facundo097/IPTC_SAS/SAS_Component_1/Spectrolab_UTJ_0.png

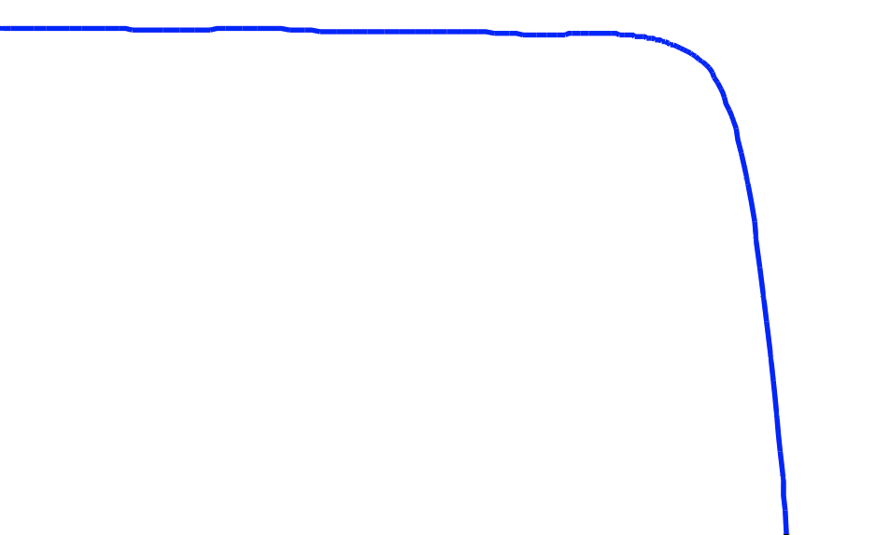
SAS_Component_1/Spectrolab_UTJ_0.png
