facundo097/IPTC_SAS/Chassis/Bill of materials.xlsx

Elemento | Cantidad | Peso Unitario | Peso Total | Precio Unitario | Precio Total
Panel frontal (acrílico de 6mm) | 1 | 0.21569 | 0.21569 | 48.08 | 48.08
Panel trasero (acrílico de 6mm) | 1 | 0.23792 | 0.23792
Panel lateral (acrílico de 6mm) | 2 | 0.32995 | 0.65990
Panel superior (acrílico de 6mm) | 1 | 0.62521 | 0.62521
Panel inferior (acrílico de 6mm) | 1 | 0.63895 | 0.63895
Anillo espaciador (acrílico de 6mm) | 4 | 0.00010 | 0.00042
Malla PVC para filtrado de polvo (https://www.amazon.com/MoKo-400x300mm-Dustproof-Magnetic-Computer/dp/B0BHSS55RM?sp_csd=d2lkZ2V0TmFtZT1zcF9hdGY) | 1 | 0.01300 | 0.01300 | 10.00 | 10.00
Convertidor AC-DC Mean Well IRM-60-24ST (https://www.mouser.co.cr/ProductDetail/MEAN-WELL/IRM-60-24ST?qs=yID0DEbBT%252Bl6uGk%2FETyecw%3D%3D) | 1 | 0.20500 | 0.20500 | 27.00 | 27.00
Conector de alimentación AC IEC320 (https://www.microjpm.com/products/ad53892/) | 1 | 0.04200 | 0.04200 | 1.95 | 1.95
Conector banana hembra NB-418 rojo (https://www.microjpm.com/products/jack-tipo-banana-o-phillips/) | 2 | 0.00200 | 0.00400 | 1.00 | 2.00
Conector banana hembra NB-418 negro (https://www.microjpm.com/products/nb-418-rojo-jack-banana-4mm/) | 2 | 0.00200 | 0.00400 | 1.00 | 2.00
Conector apilable de 6 pines de 2.54 mm (https://www.microjpm.com/products/stackable-header-6-pins-2-54mm/) | 1 | 0.00100 | 0.00100 | 0.45 | 0.45
Interruptor rocker KCD3 (https://www.microjpm.com/products/ad71231/) | 1 | 0.00799 | 0.00799 | 3.50 | 3.50
Interruptor rotatorio LA38-20X3 (https://www.microjpm.com/products/ad70325/) | 1 | 0.03997 | 0.03997 | 13.95 | 13.95
Conector USB hembra-hembra (https://www.microjpm.com/products/ad37276/) | 2 | 0.03203 | 0.06407 | 3.95 | 7.90
Cable MicroUSB 80 cm (https://www.crcibernetica.com/usb-microb-cable-80-cm/) | 1 | 0.01000 | 0.01000 | 4.95 | 4.95
Cable MiniUSB 80 cm (https://www.crcibernetica.com/usb-mini-b-cable-80-cm/) | 1 | 0.01000 | 0.01000 | 4.95 | 4.95
Soporte interior de 90° de 3 vías con roscado M4 (https://www.crcibernetica.com/3-way-90-degree-inside-bracket-for-2020-extrusion/) | 8 | 0.01040 | 0.08318 | 1.95 | 15.60
Separador hexagonal M3 macho x hembra 15 mm (https://www.microjpm.com/products/ad39853/) | 18 | 0.00303 | 0.05461 | 0.40 | 7.20
Tornillo M2 x 14 mm (https://www.crcibernetica.com/m2-screw-10pcs/) | 4 | 0.00039 | 0.00154 | 0.20 | 0.80
Tornillo M3 x 12 mm (https://www.microjpm.com/products/ad37024/) | 18 | 0.00094 | 0.01685 | 0.07 | 1.26
Tornillo M3 x 18 mm (https://www.microjpm.com/products/ad37035/) | 8 | 0.00120 | 0.00962 | 0.08 | 0.64
Tornillo M4 x 12 mm (https://www.microjpm.com/products/m4-x-10mm-tornillo-philips/) | 32 | 0.00175 | 0.05600 | 0.10 | 3.20
Tuerca M2 (https://www.crcibernetica.com/m2-hex-nut-10pcs/) | 4 | 0.00014 | 0.00056 | 0.20 | 0.80
Tuerca M3 (https://www.microjpm.com/products/m3-tuerca-3mm-hexagonal-acero-inoxidable/) | 36 | 0.00038 | 0.01368 | 0.06 | 2.16
Arandela M3 (https://www.mayzapcr.com/arandela-plana-metrica-inoxidable/) | 4 | 0.00008 | 0.00031 | 0.02 | 0.08
 |  | Total (kg) | 3.02 | Total ($) | 158.47
Nota: el catálogo en línea de MicroJPM y CRCibernética en tornillos/tuercas/arandelas es muy reducido. En Tornillos Toyman Cartago probablemente se encuentre todo lo que se necesita y más barato:
https://maps.app.goo.gl/YtZ4RZrFzbNQJieW9
