facundo097/IPTC_SAS/SAS_Component_1/AZUR_3G30A_0.png

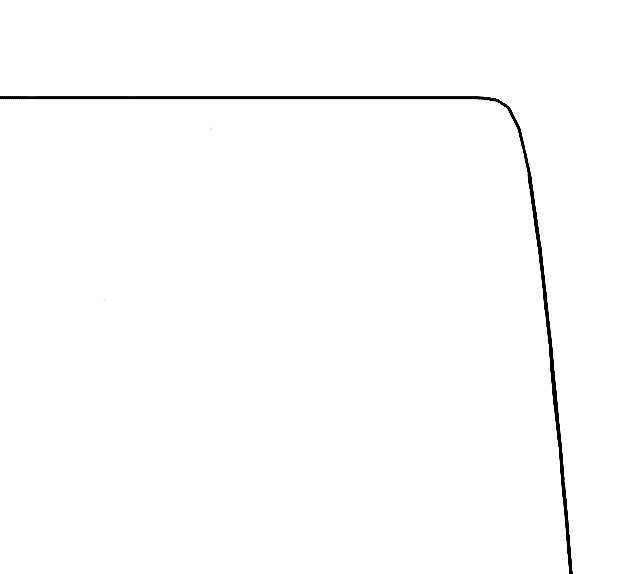
SAS_Component_1/AZUR_3G30A_0.png
