facundo097/IPTC_SAS/SAS_Component_1/AZUR_4G32C_0.png

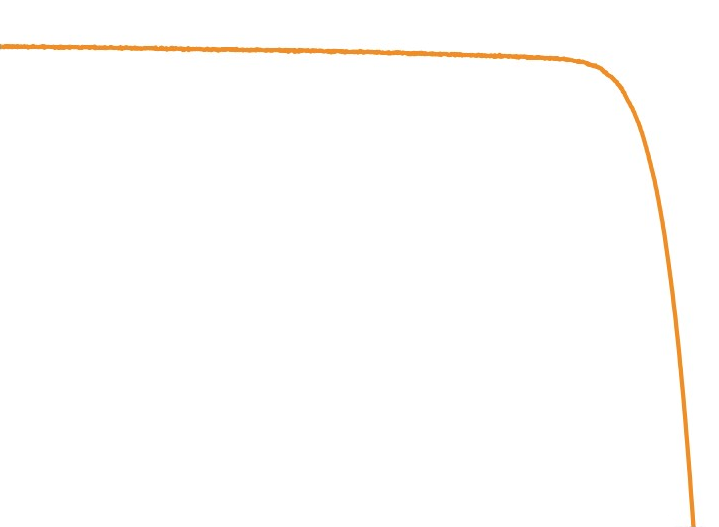
SAS_Component_1/AZUR_4G32C_0.png
