facundo097/IPTC_SAS/(list of files, cad)

Other CAD files:
Chassis/Laser Cut/Laser_Cut.dwg
