facundo097/IPTC_SAS/Guides/IPCT SAS IoT Platform Guide.pdf

### IPCT SAS IoT Platform Guide

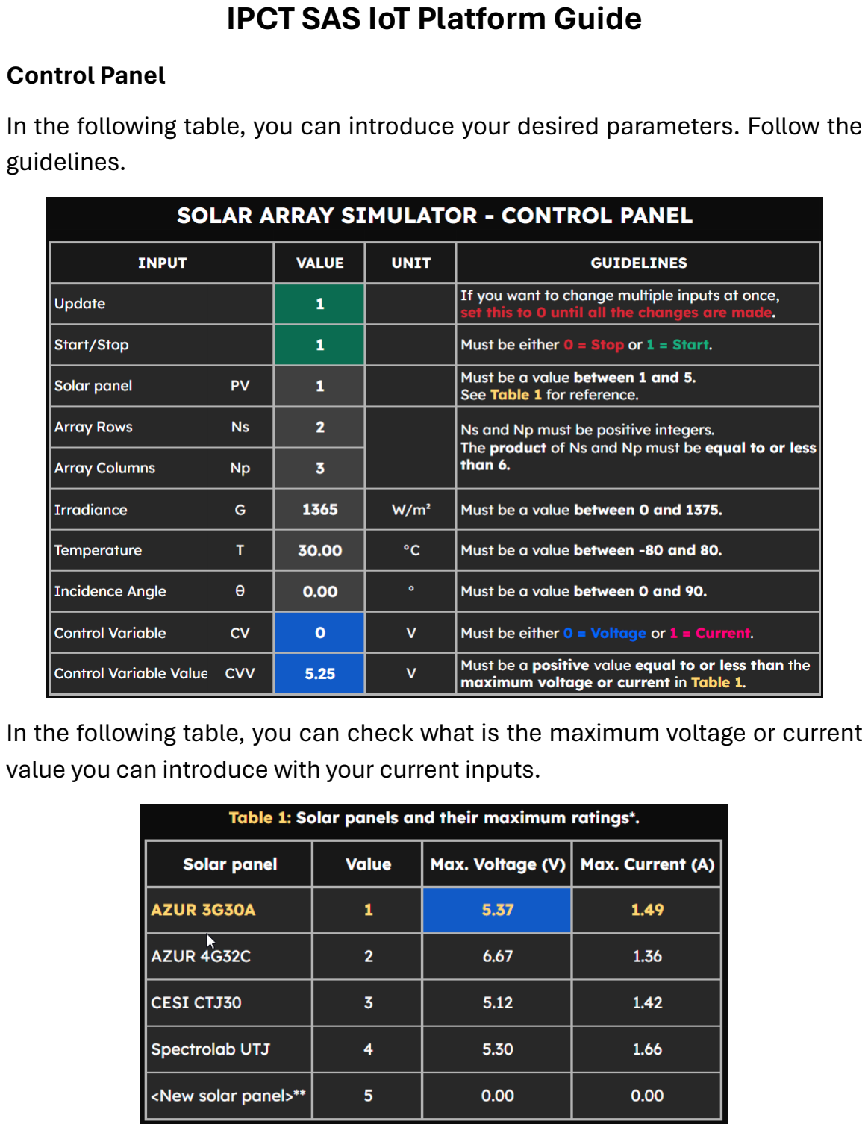
[picture p33: page 1]

Control Panel
In the following table, you can introduce your desired parameters. Follow the guidelines.

In the following table, you can check what is the maximum voltage or current value you can introduce with your current inputs.

In one or more of the inputs you introduced are invalid, the platform will notify you which are causing problems and the platforms won’t be able to receive any parameters until they are corrected.

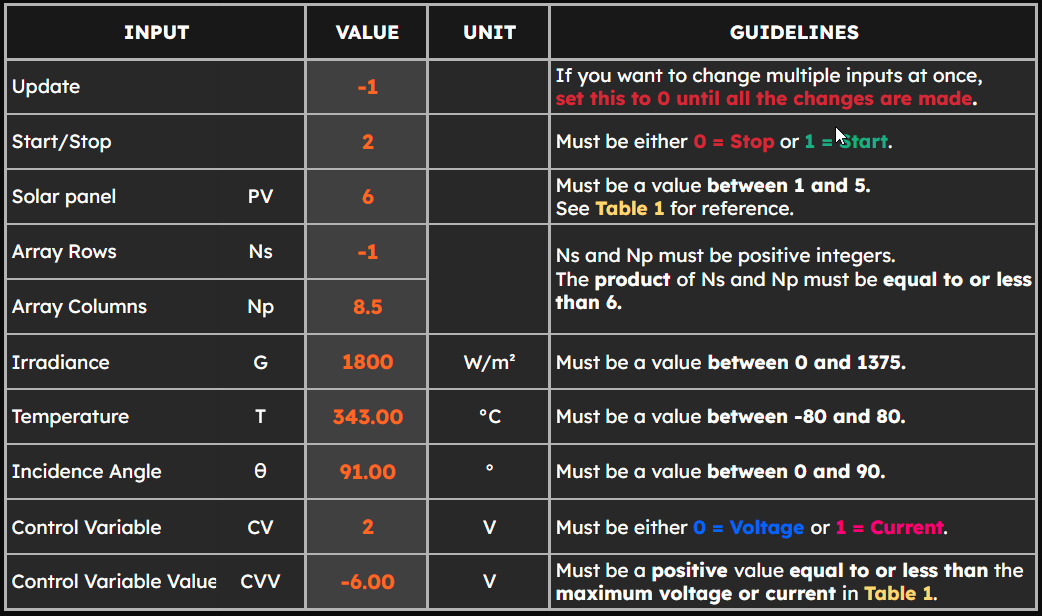
[picture p34: figure]
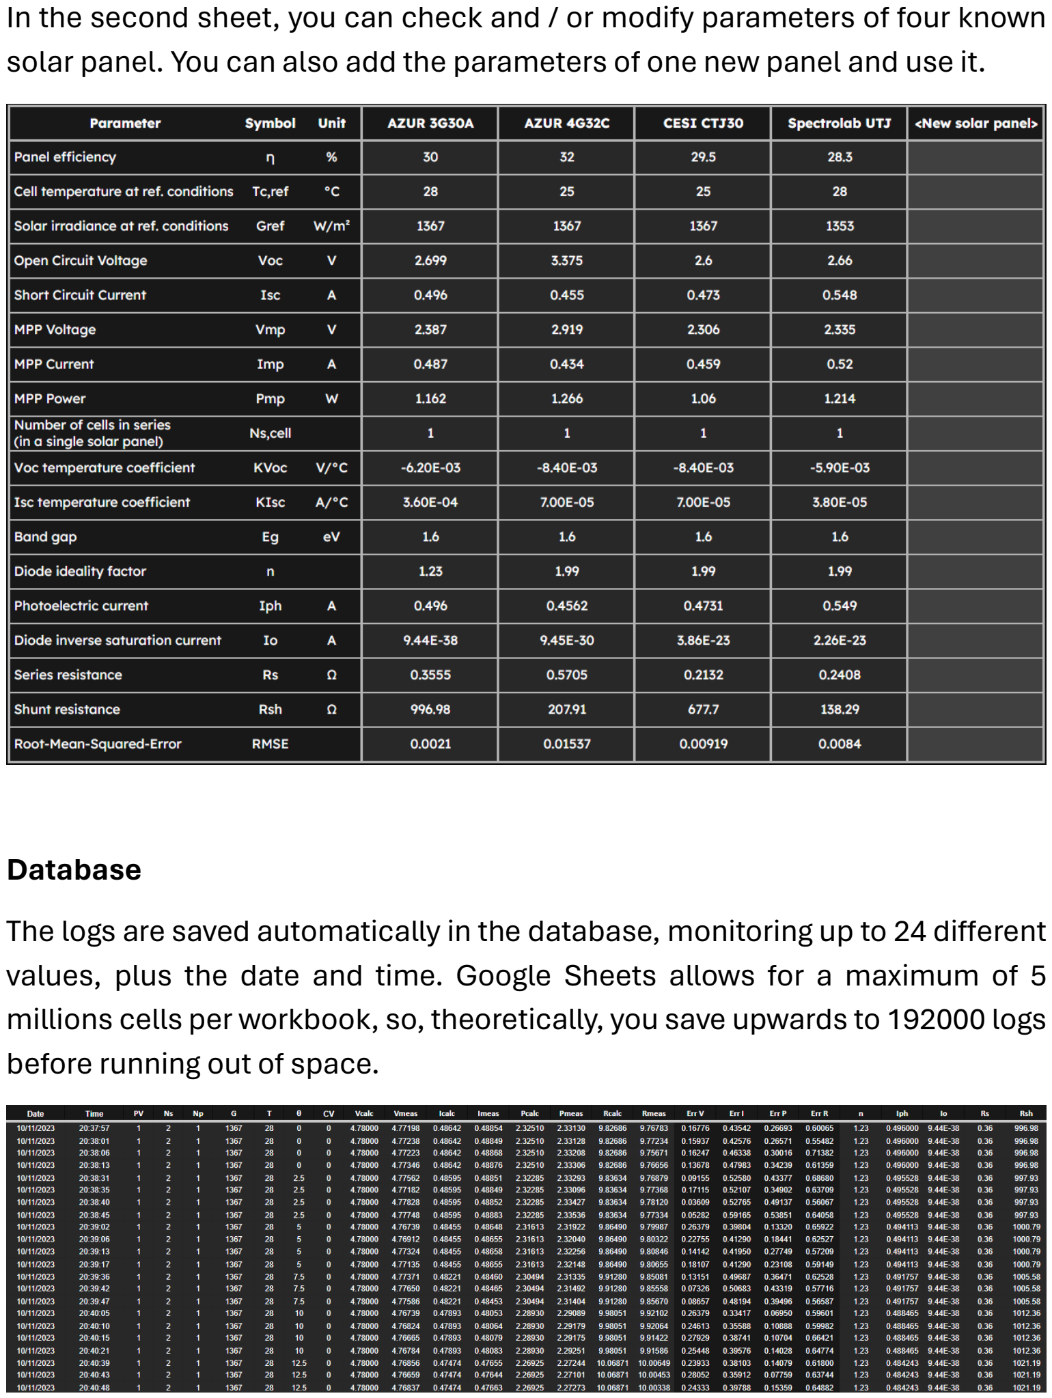
[picture p35: page 3]

In the second sheet, you can check and / or modify parameters of four known solar panel. You can also add the parameters of one new panel and use it.

Database
The logs are saved automatically in the database, monitoring up to 24 different values, plus the date and time. Google Sheets allows for a maximum of 5 millions cells per workbook, so, theoretically, you save upwards to 192000 logs before running out of space.

Visualization Panel
The following table allows you to see the last logged values in multiple parameters, the time between the first and last logs, and an error analysis of all the logs.

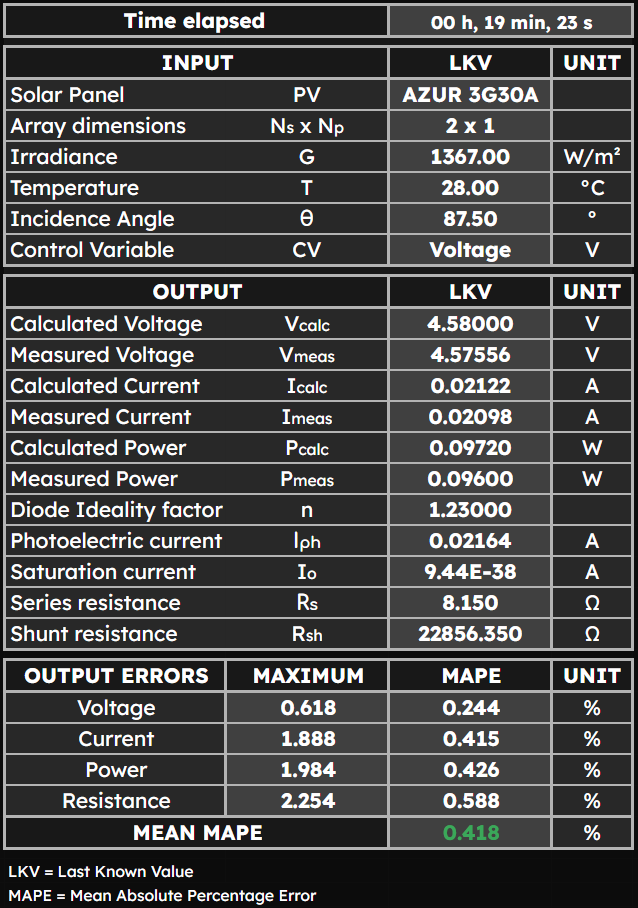
[picture p36: figure]

There are plots that allow you to see the change in the outputs in function of time, as well as the associated errors. There are also plots that monitor the change in current and power in function of the voltage, allowing to see real-time characteristic curves.

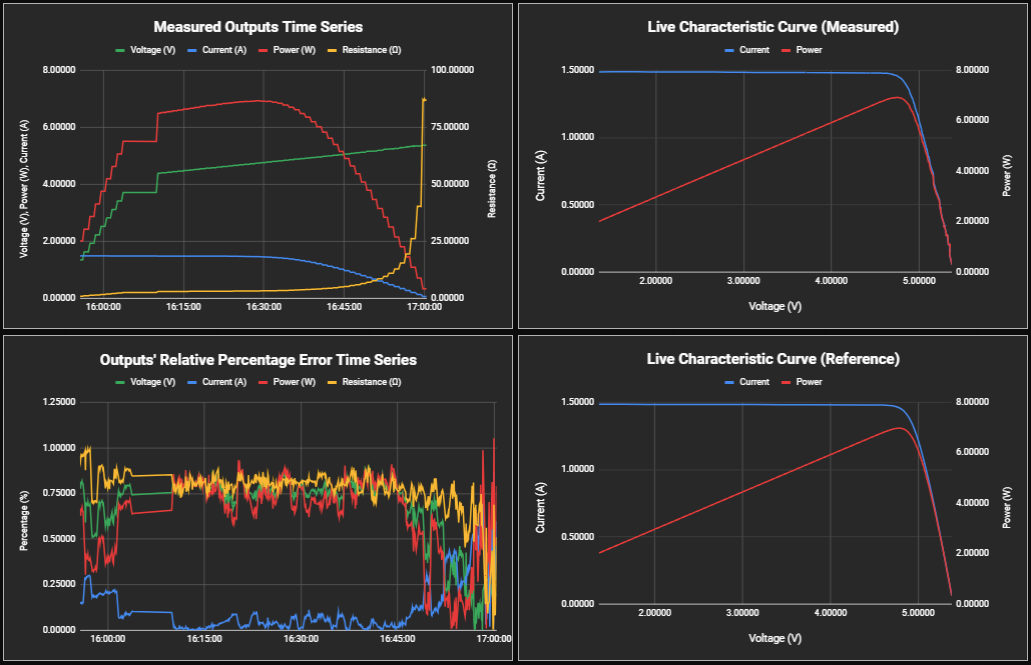
[picture p37: figure]
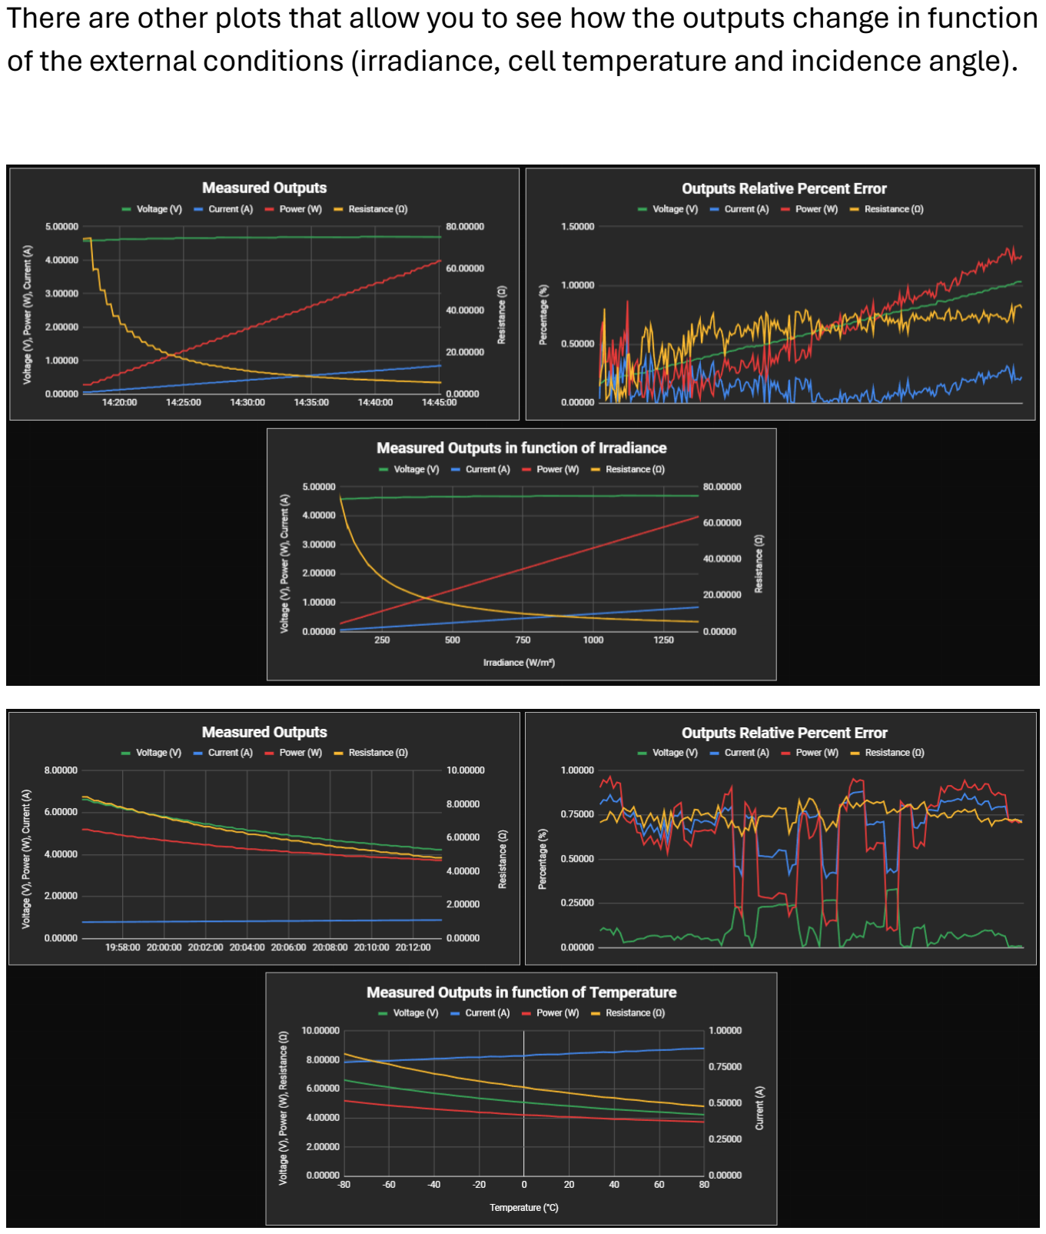
[picture p38: page 6]

There are other plots that allow you to see how the outputs change in function of the external conditions (irradiance, cell temperature and incidence angle).

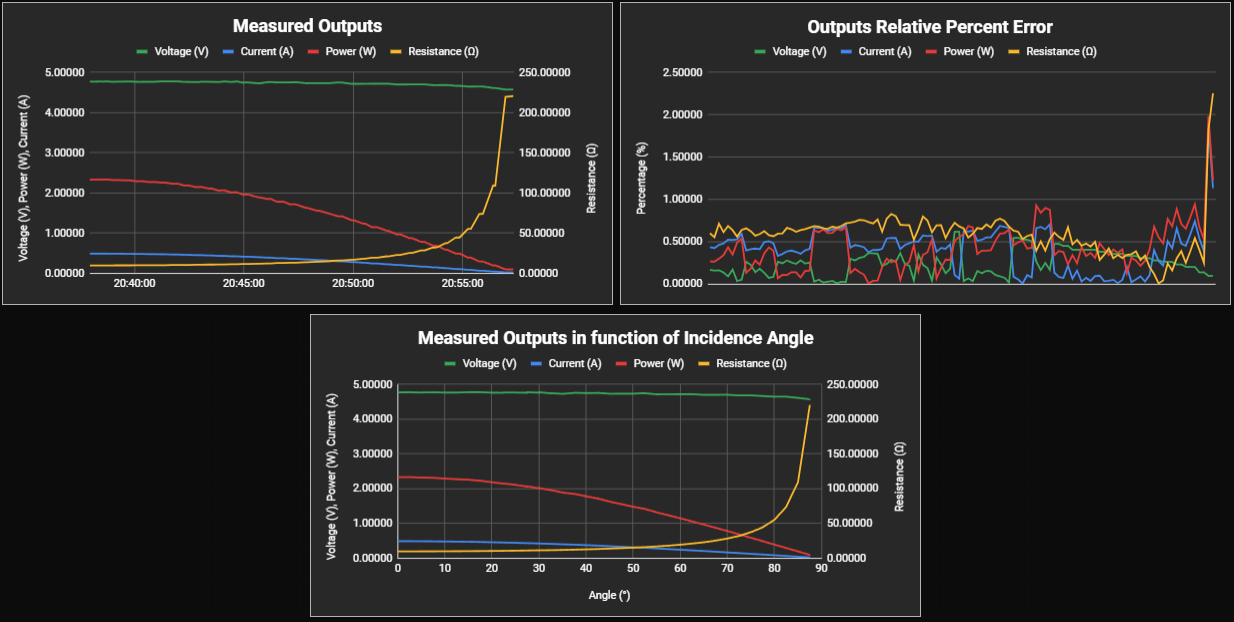
[picture p39: figure]
