facundo097/IPTC_SAS/SAS_Component_2/Analytical_Model_Tests/Analytic_Model_Excecution_Times.xlsx

Sheet: Platform1
t | V | I | G | T | Ang | Mean time (ms) | StDev Time (ms) | Max | Min
0.0002902000015 | 2.455832775 | 0.01793679582 | 233 | -43 | 77 | 0.6009 | 0.2333 | 1.525500 | 0.253600
0.000285099999 | 4.323012409 | 0.1175817252 | 349 | -34 | 11
0.0002888999988 | 3.282568518 | 0.06886260887 | 1073 | -63 | 79
0.0002894000027 | 4.990359757 | 0.06882350142 | 224 | -26 | 27
0.0002761999967 | 3.040541599 | 0.1060928273 | 576 | -21 | 58
0.0002741999997 | 3.305118355 | 0.2574011163 | 1097 | 18 | 49
0.0002654000018 | 3.699867198 | 0.09169328237 | 342 | -10 | 40
0.0002925999979 | 4.050117896 | 0.1044157518 | 546 | -72 | 55
0.0002773999986 | 3.432294942 | 0.1699103614 | 1242 | 47 | 68
0.0003098000016 | 4.543625648 | 0.3496490291 | 1082 | 69 | 27
0.0002726999992 | 3.035080941 | 0.2314563885 | 646 | 23 | 4 |  |  | Parámetro | Plataforma 1 | Plataforma 2
0.0003300999997 | 2.884195514 | 0.2737279929 | 794 | -32 | 1 |  |  | Tiempo promedio (ms) | 0.60090 | 2.09655
0.0002666999972 | 3.027628994 | 0.4357317123 | 1316 | 58 | 26 |  |  | Desviación estándar (ms) | 0.23329 | 0.43602
0.0002658999983 | 2.93354087 | 0.2191266453 | 656 | -49 | 11 |  |  | Tiempo máximo (ms) | 1.52550 | 5.00000
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
