facundo097/IPTC_SAS/IoT_Platform/Tests/Response_Times_Control_Panel.xlsx

Sheet: platform_1
counter | t | msg | mean time | stdev | max | min
1 | 2.1818 | i,1,4,1,6,1100,25,15,0,0.5,d,28,1353,2.66,0.548,2.335,0.52,1.214,1,-0.0059,0.000038,1.6,p,1.99,0.549,2.26E-23,0.2408,138.29 | 2.1853 | 0.6338 | 15.4200 | 1.5710
2 | 2.3317 | i,1,4,1,6,1100,25,15,0,0.5,d,28,1353,2.66,0.548,2.335,0.52,1.214,1,-0.0059,0.000038,1.6,p,1.99,0.549,2.26E-23,0.2408,138.29
3 | 1.8886 | i,1,4,1,6,1100,25,15,0,0.5,d,28,1353,2.66,0.548,2.335,0.52,1.214,1,-0.0059,0.000038,1.6,p,1.99,0.549,2.26E-23,0.2408,138.29
4 | 1.8825 | i,1,4,1,6,1100,25,15,0,0.5,d,28,1353,2.66,0.548,2.335,0.52,1.214,1,-0.0059,0.000038,1.6,p,1.99,0.549,2.26E-23,0.2408,138.29
5 | 2.0158 | i,1,4,1,6,1100,25,15,0,0.5,d,28,1353,2.66,0.548,2.335,0.52,1.214,1,-0.0059,0.000038,1.6,p,1.99,0.549,2.26E-23,0.2408,138.29
6 | 2.5806 | i,1,4,1,6,1100,25,15,0,0.5,d,28,1353,2.66,0.548,2.335,0.52,1.214,1,-0.0059,0.000038,1.6,p,1.99,0.549,2.26E-23,0.2408,138.29
7 | 1.9956 | i,1,4,1,6,1100,25,15,0,0.5,d,28,1353,2.66,0.548,2.335,0.52,1.214,1,-0.0059,0.000038,1.6,p,1.99,0.549,2.26E-23,0.2408,138.29
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
