facundo097/IPTC_SAS/Chassis/Drawings/IPTC-SAS-01.pdf

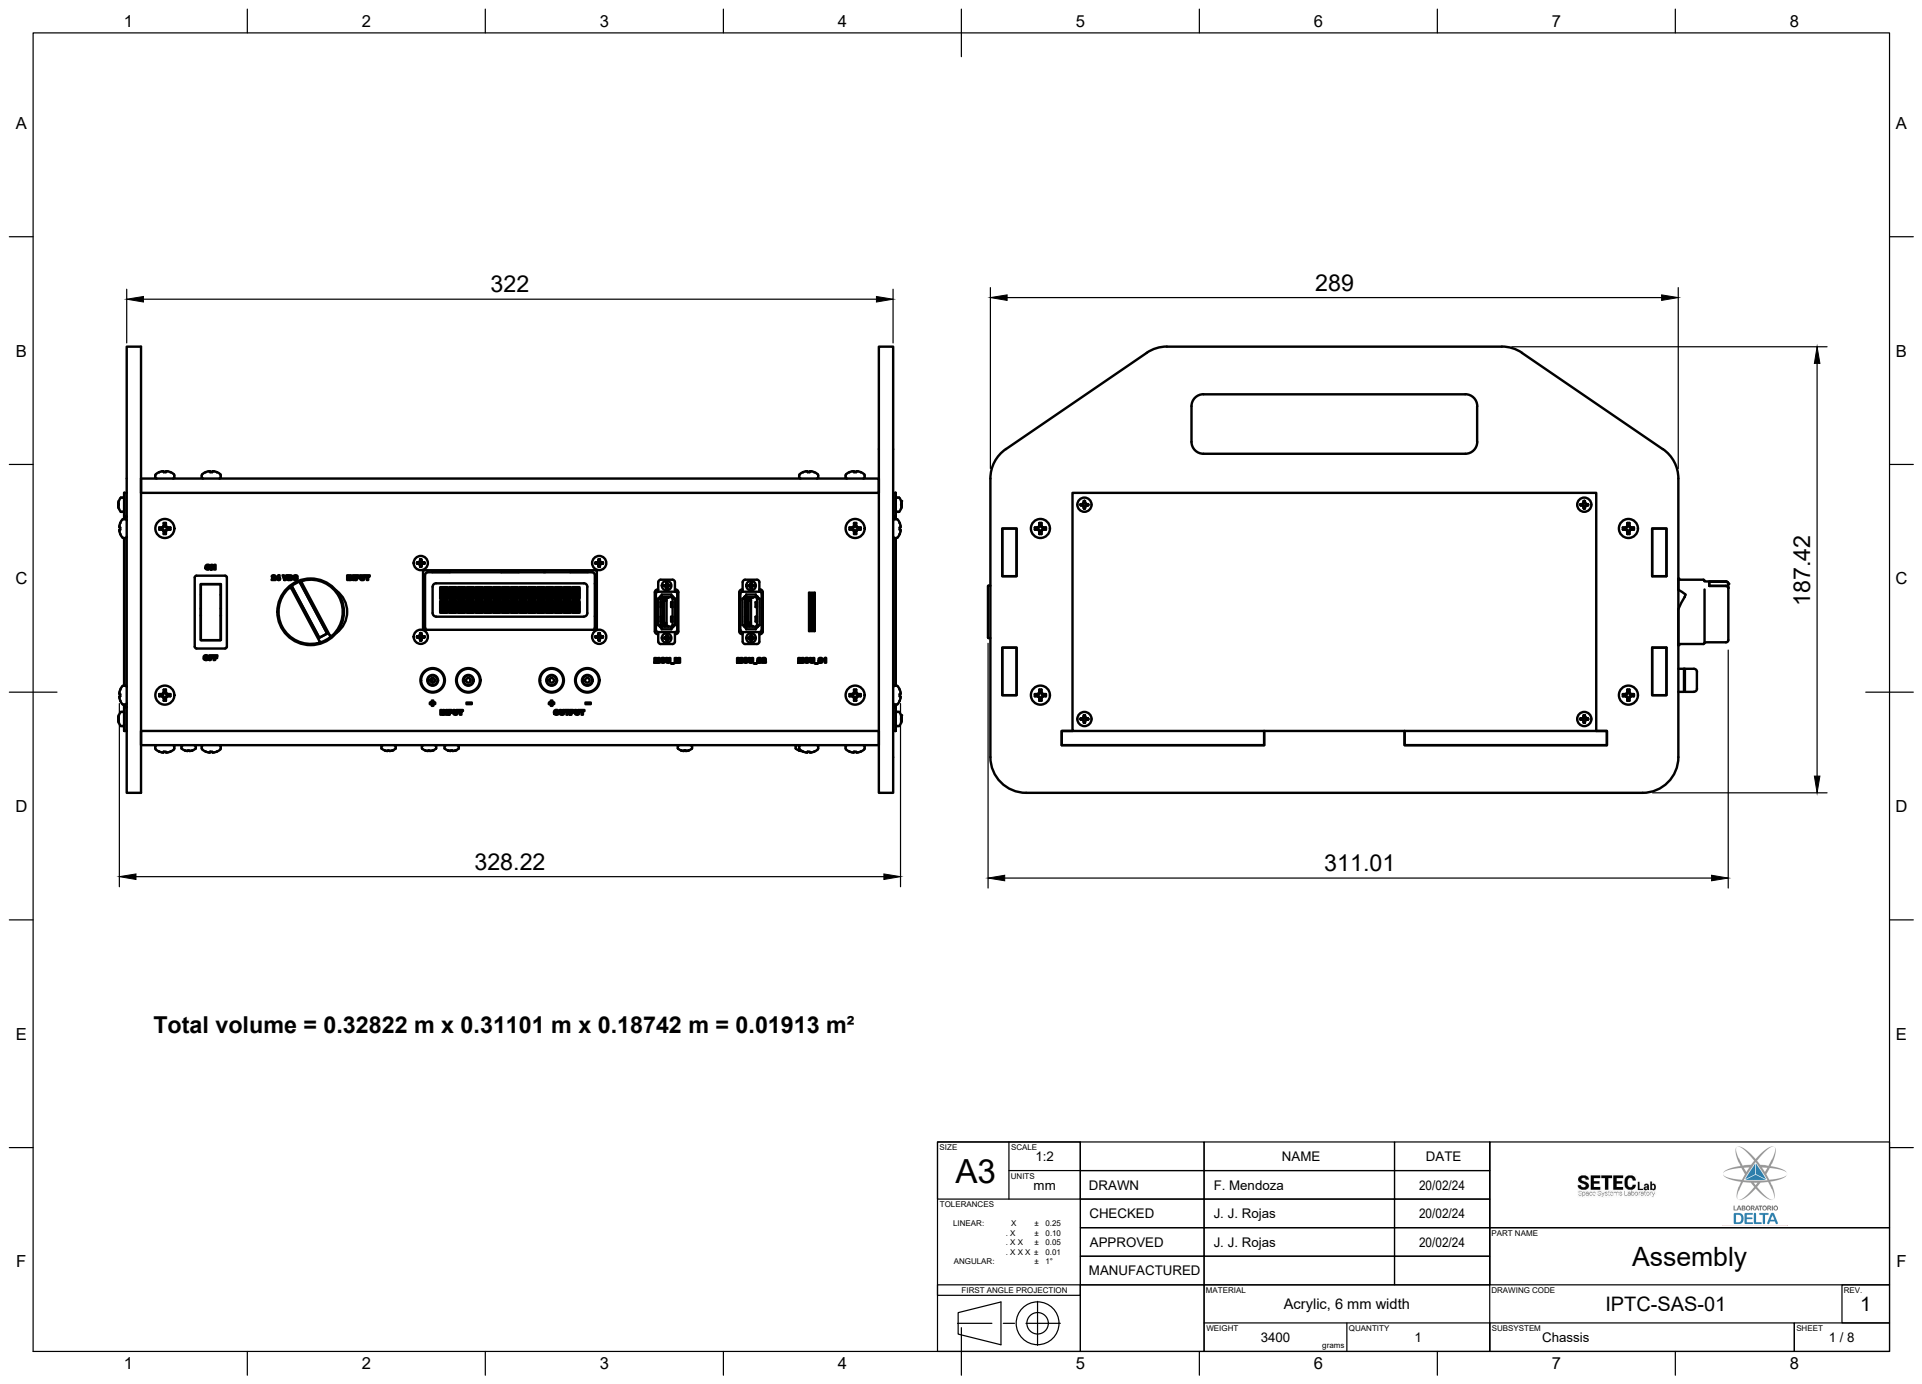
[picture p56: page 1]
Chassis

Total volume = 0.32822 m x 0.31101 m x 0.18742 m = 0.01913 m²

SIZE A3 | SCALE UNITS 1:2 | | NAME | DATE

mm | DRAWN | F. Mendoza | 20/02/24

TOLERANCES X ± 0.25 LINEAR: . X ± 0.10 . X X ± 0.05 . X X X ± 0.01 ANGULAR: ± 1° | | CHECKED | J. J. Rojas | 20/02/24

APPROVED | J. J. Rojas | 20/02/24 | PART NAME Assembly
MANUFACTURED

FIRST ANGLE PROJECTION | | MATERIAL Acrylic, 6 mm width | DRAWING CODE IPTC-SAS-01 | REV. 1
