facundo097/IPTC_SAS/Chassis/Drawings/IPTC-SAS-03.pdf

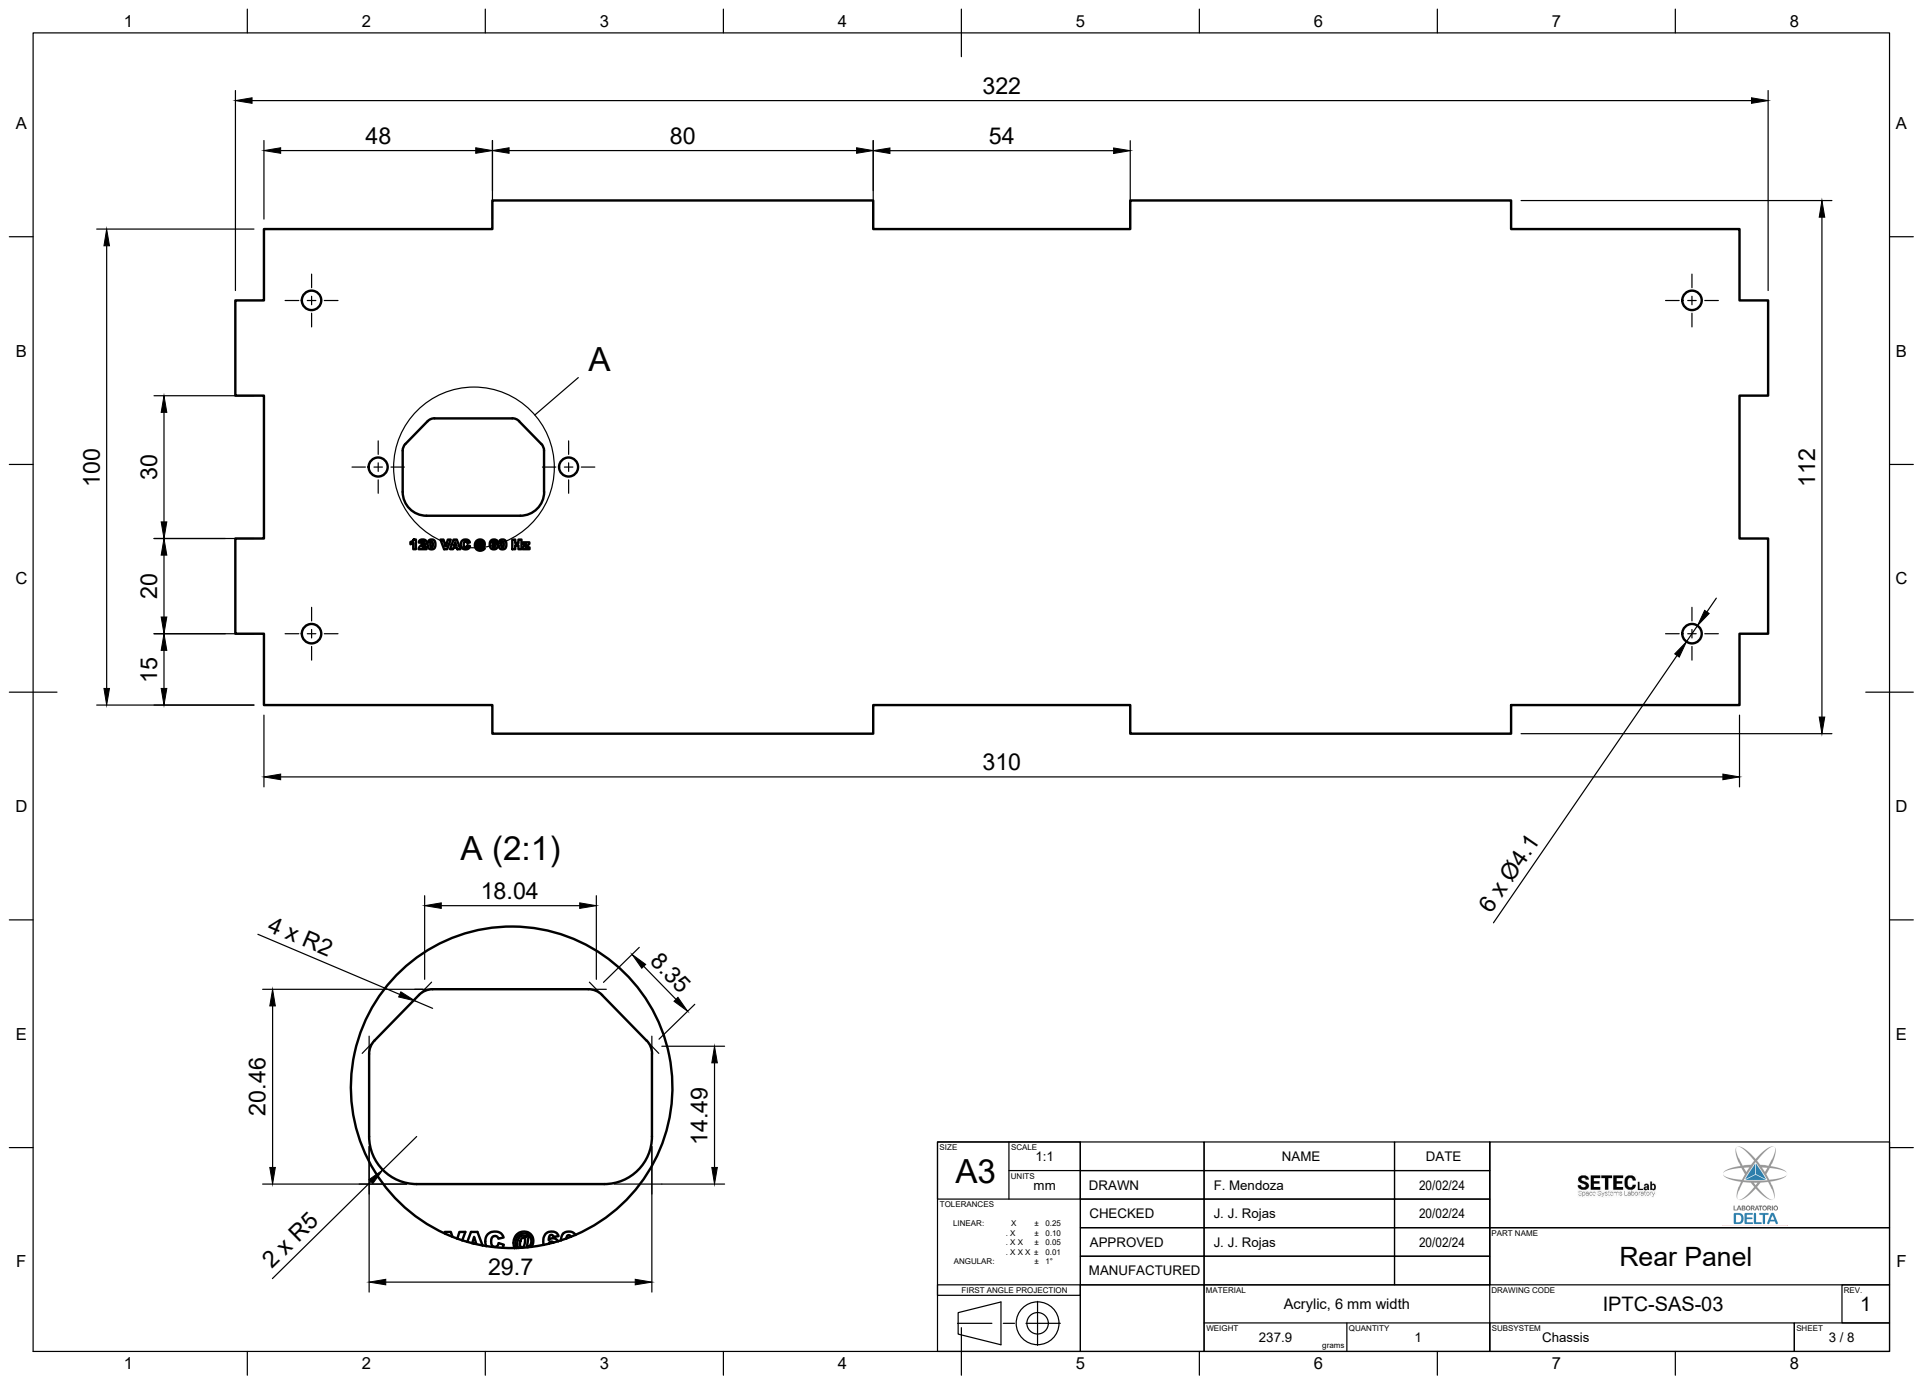
[picture p57: page 1]
Chassis

SIZE A3 | SCALE UNITS 1:1 | | NAME | DATE

mm | DRAWN | F. Mendoza | 20/02/24

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

APPROVED | J. J. Rojas | 20/02/24 | PART NAME Rear Panel
MANUFACTURED

FIRST ANGLE PROJECTION | | MATERIAL Acrylic, 6 mm width | DRAWING CODE IPTC-SAS-03 | REV. 1
