facundo097/IPTC_SAS/Chassis/Drawings/IPTC-SAS-07.pdf

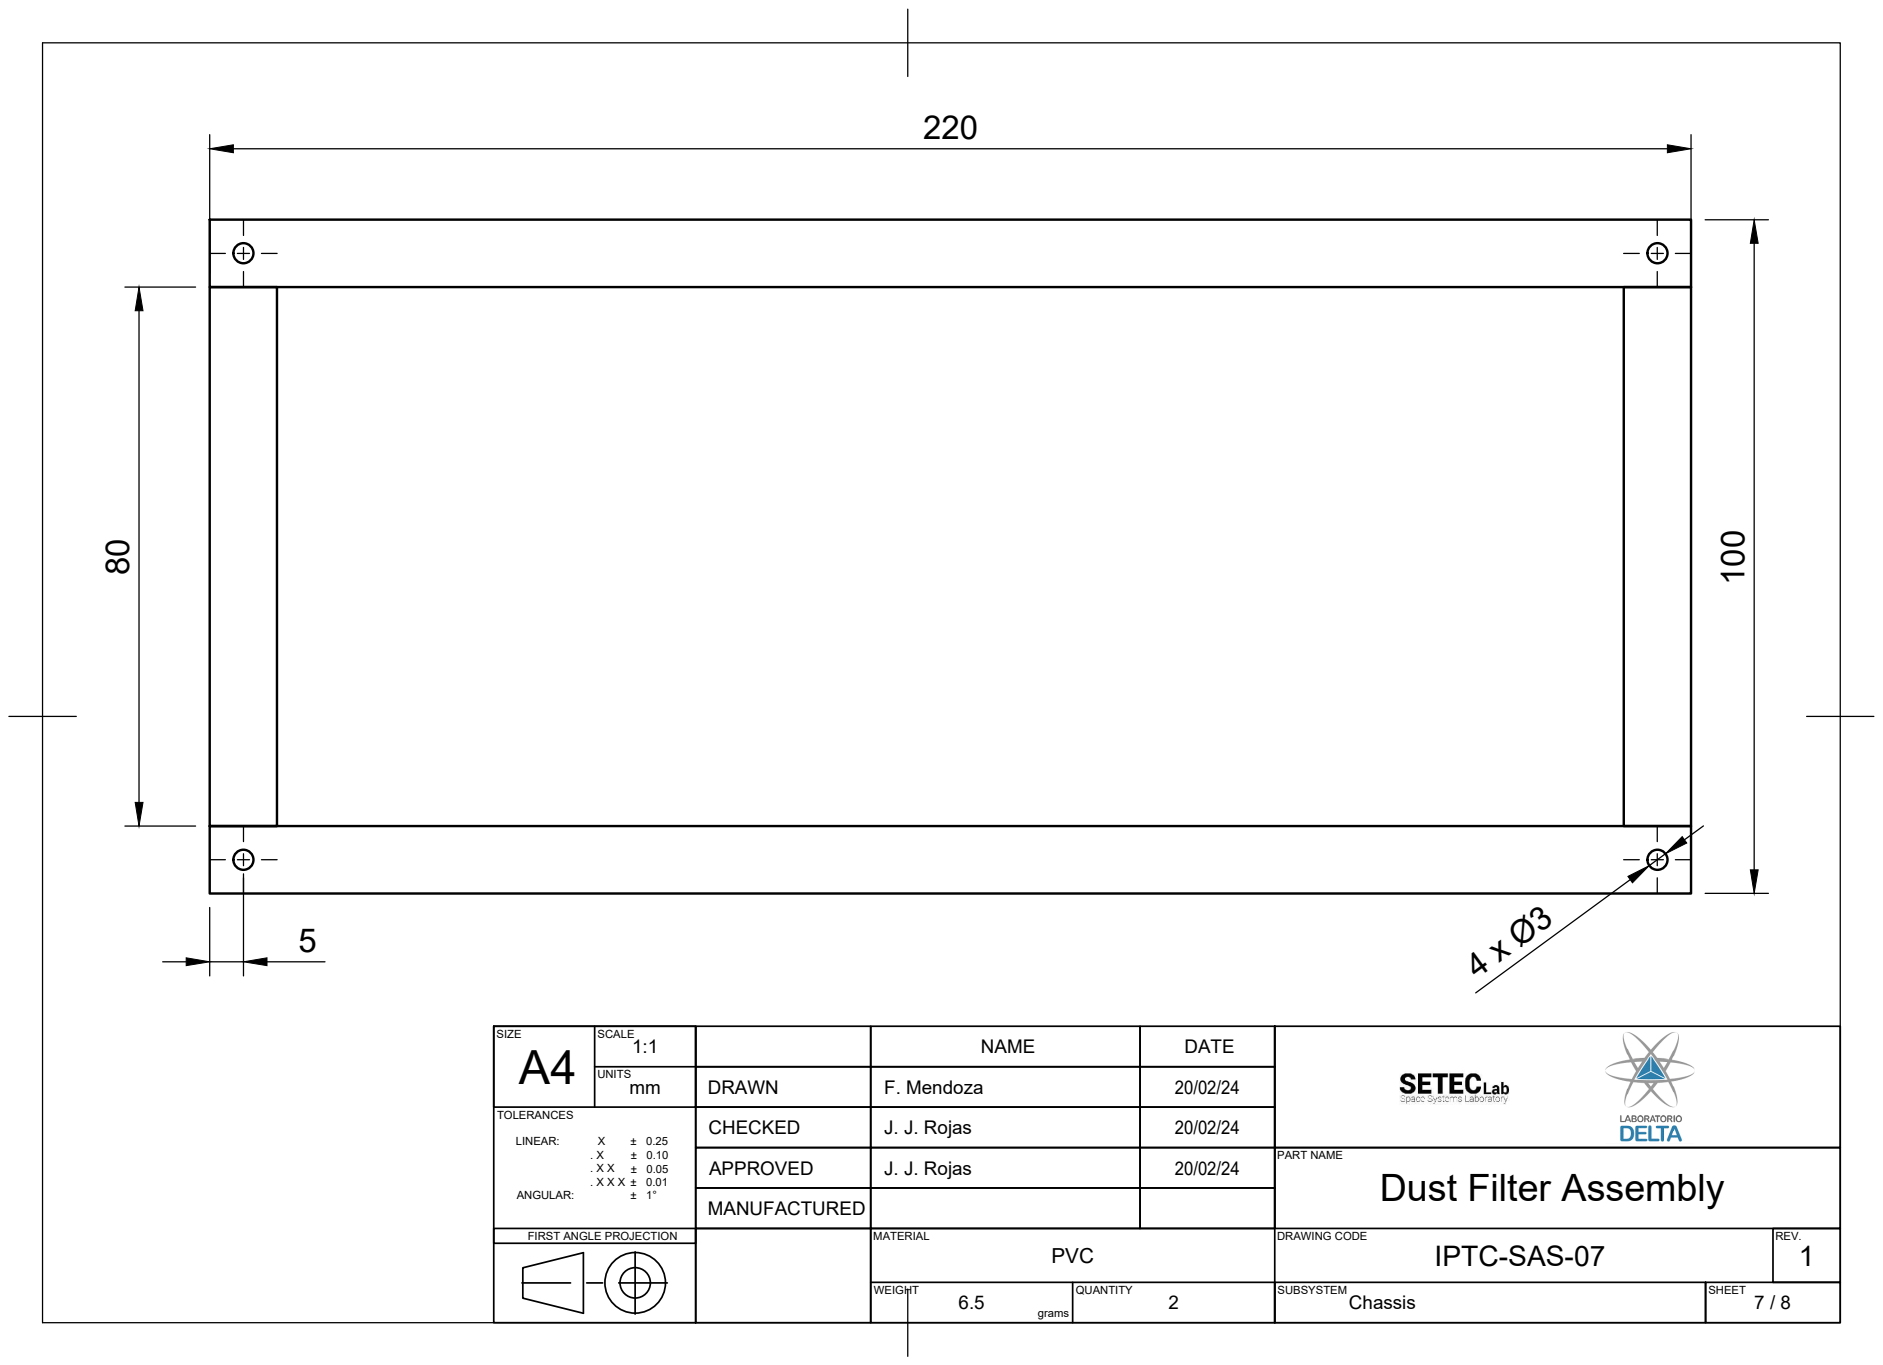
[picture p58: page 1]
PART NAME Chassis

SIZE | SCALE 1:1 | DRAWN | NAME | DATE
UNITSmm X ± 0.25 LINEAR: ANGULAR: TOLERANCES . X ± 0.10 . X X ± 0.05 . X X X ± 0.01 ± 1° | | CHECKED | WEIGHT QUANTITY A4 J. J. Rojas | 20/02/24

F. Mendoza | 20/02/24

APPROVED | J. J. Rojas | 20/02/24 | Dust Filter Assembly

MANUFACTURED

FIRST ANGLE PROJECTION | | MATERIAL PVC | IPTC-SAS-07 | REV. SHEET DRAWING CODE 1
