facundo097/IPTC_SAS/Chassis/Drawings/IPTC-SAS-08.pdf

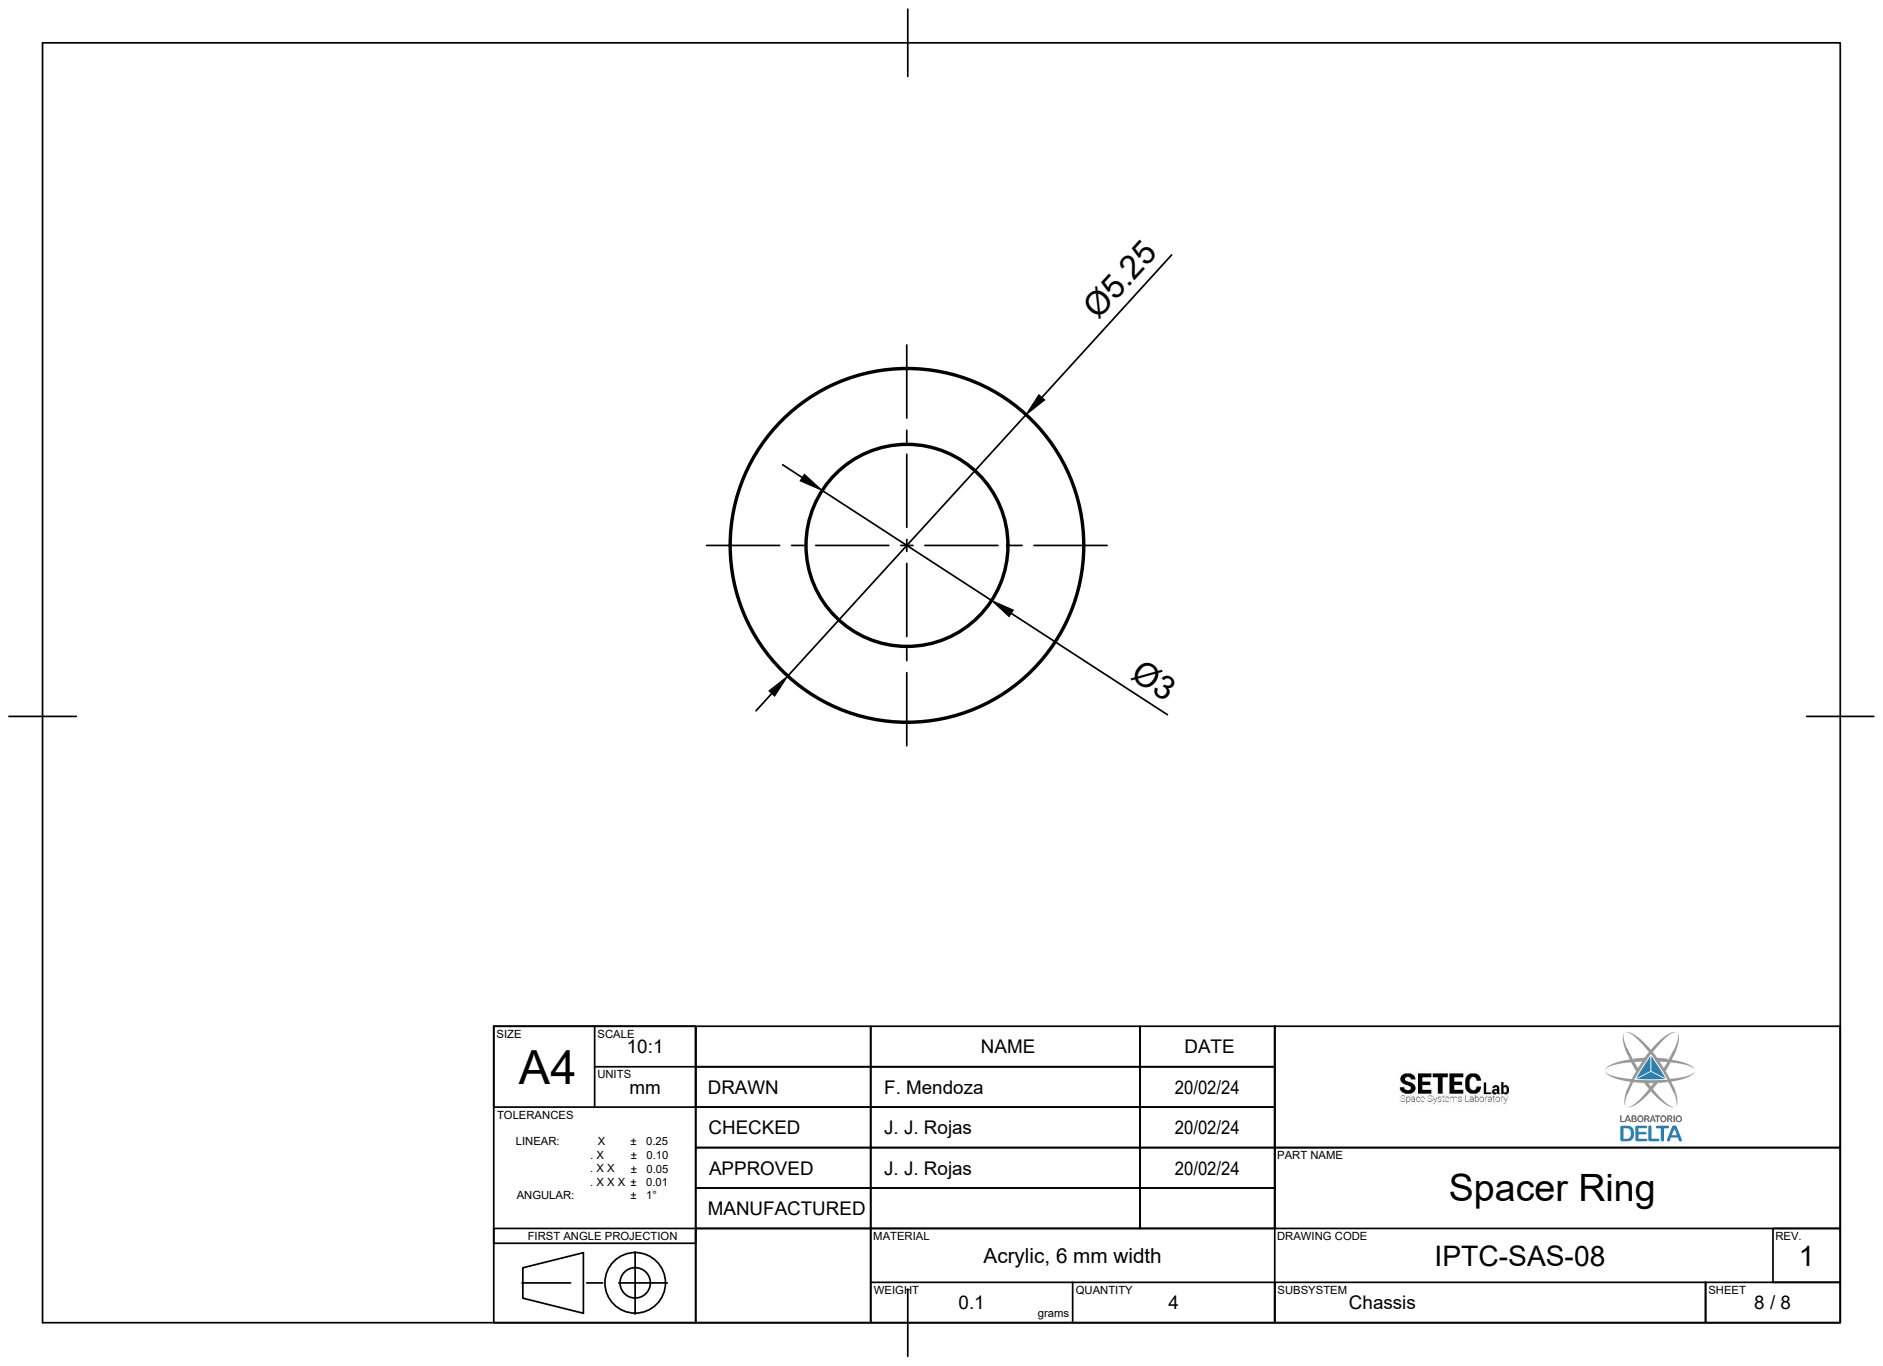
[picture p59: page 1]
PART NAME Chassis

SIZE | SCALE 10:1 | DRAWN | NAME | DATE
UNITSmm X ± 0.25 LINEAR: ANGULAR: TOLERANCES . X ± 0.10 . X X ± 0.05 . X X X ± 0.01 ± 1° | | CHECKED | WEIGHT QUANTITY A4 J. J. Rojas | 20/02/24

F. Mendoza | 20/02/24

APPROVED | J. J. Rojas | 20/02/24 | Spacer Ring

MANUFACTURED

FIRST ANGLE PROJECTION | | MATERIAL Acrylic, 6 mm width | IPTC-SAS-08 | REV. SHEET DRAWING CODE 1
