facundo097/IPTC_SAS/Chassis/Laser Cut/Laser_6mm_400x250mm.pdf

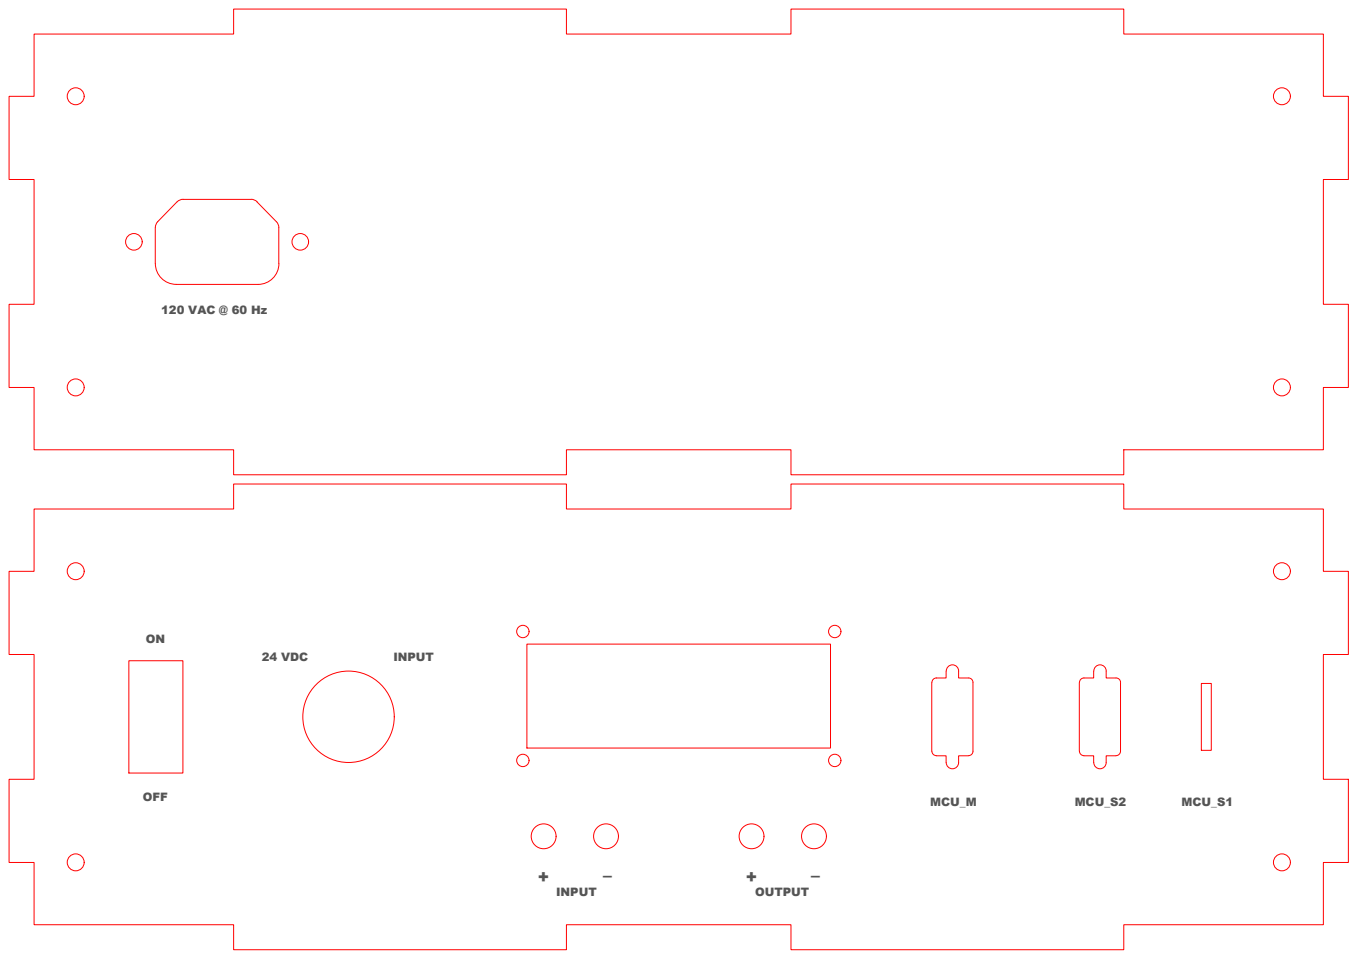
[picture p60: page 1]
24 VDC; INPUT; 120 VAC @ 60 Hz
