facundo097/IPTC_SAS/Chassis/Laser Cut/Laser_6mm_800x500mm.pdf

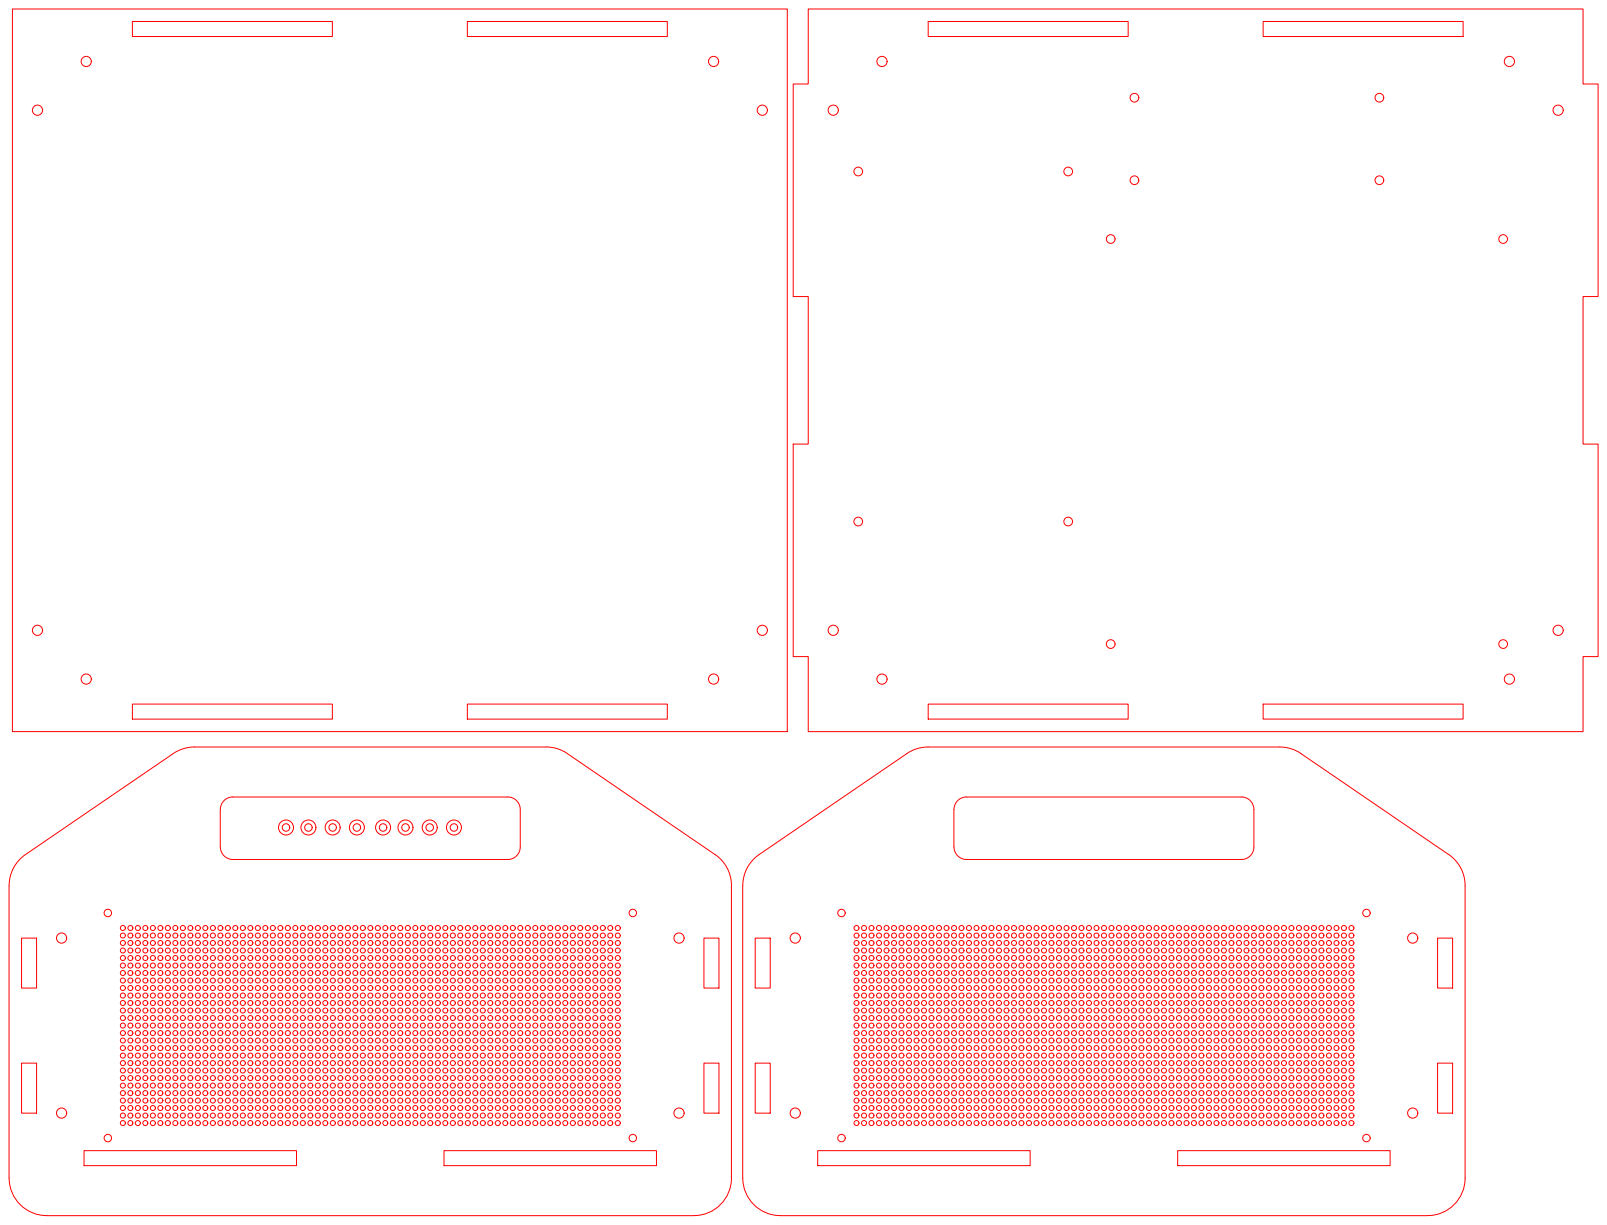
[picture p61: page 1]
