facundo097/IPTC_SAS/SAS_Component_2/SAS_with_MCUs/IPTC_SAS_ESP8266/Secrets.h

const char* ssid; 
const char* password; 

const char* ssid_1 = "HomeWifi"; 
const char* password_1 = "HomeWifiPassword"; 

const char* ssid_2 = "LabDeltaWifi"; 
const char* password_2 = "LabDeltaWifiPassword"; 

String GAS_ID_DATA_BASE = "enter-data-base-gas-id"; 
String GAS_ID_CONTROL_PANEL = "enter-control-panel-gas-id"; 
